NinoBleus/ES2_Amplifier/pcb/audio-amplifier/audio-amplifier.pdf

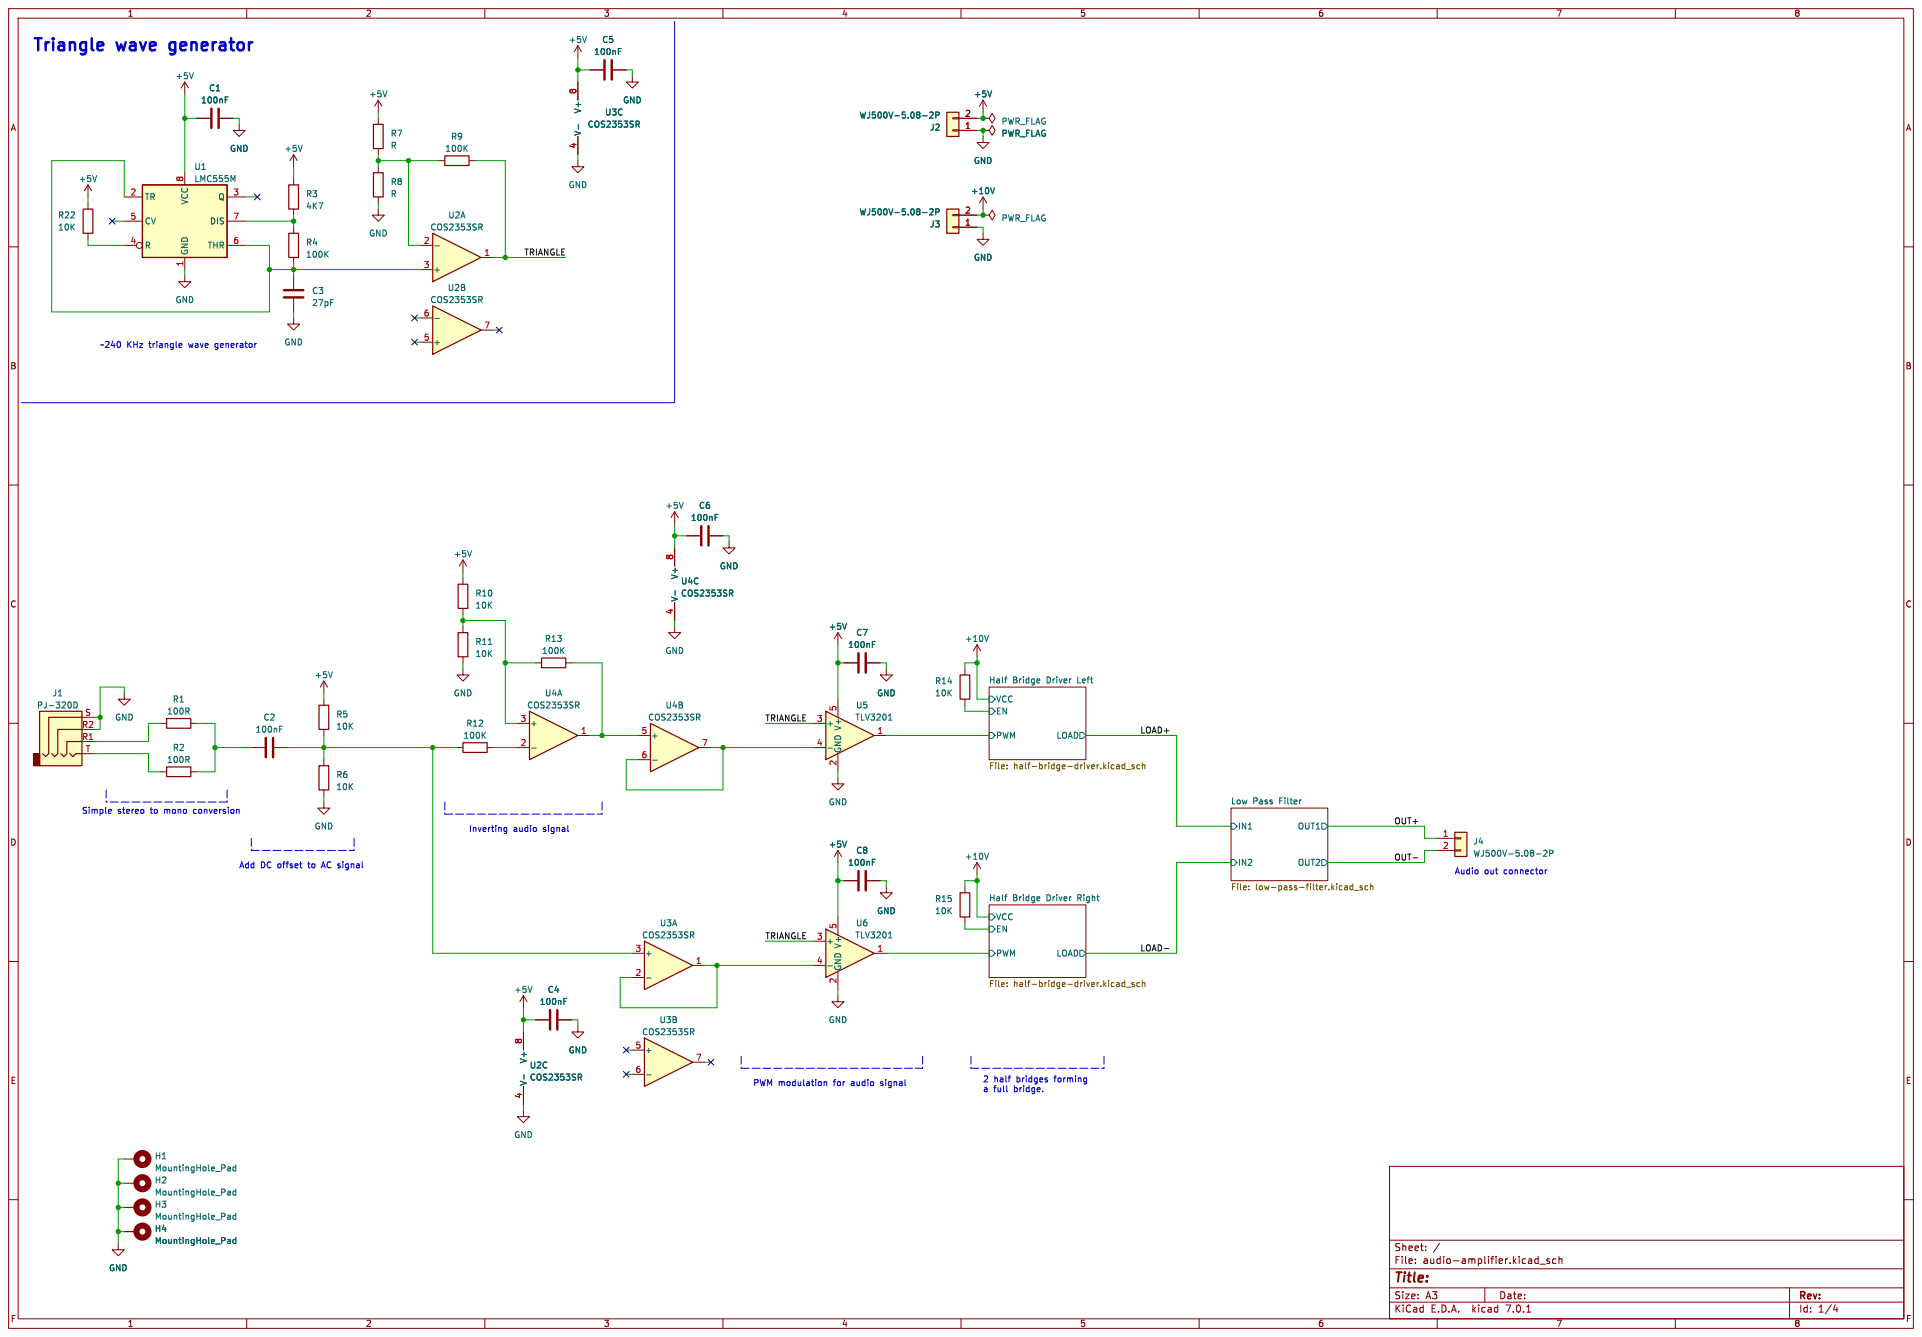
[picture p1: page 1]

Half Bridge Driver Left File: half-bridge-driver.kicad_sch

Low Pass Filter File: low-pass-filter.kicad_sch

Half Bridge Driver Right File: half-bridge-driver.kicad_sch

Id: 1/4 Title: File: audio-amplifier.kicad_sch Sheet: /

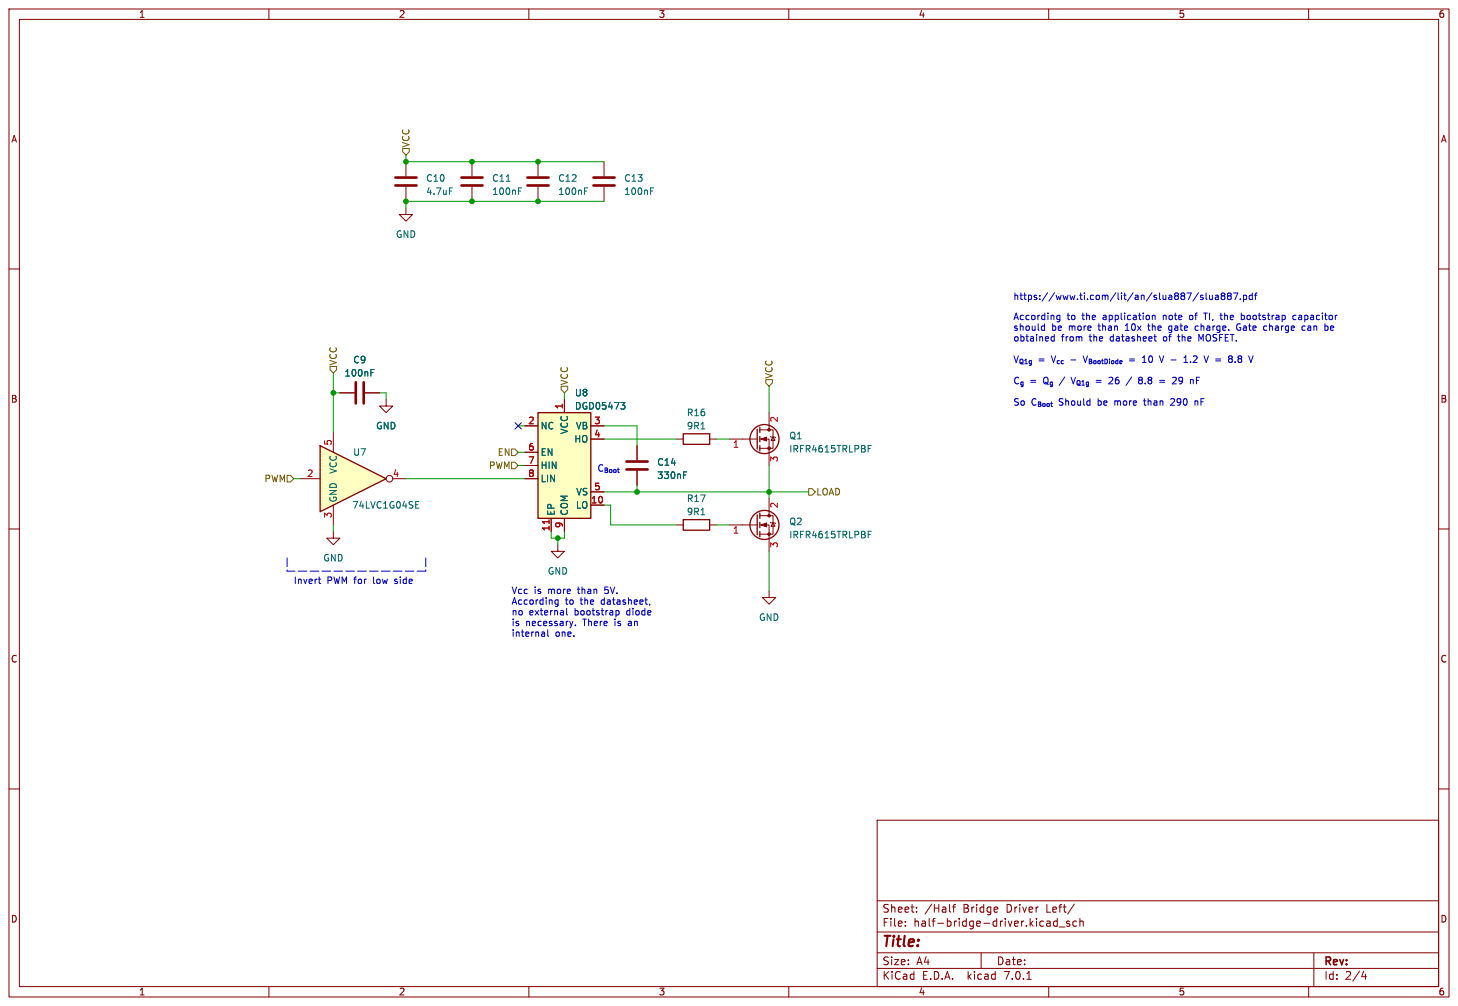
[picture p2: page 2]

https://www.ti.com/lit/an/slua887/slua887.pdf

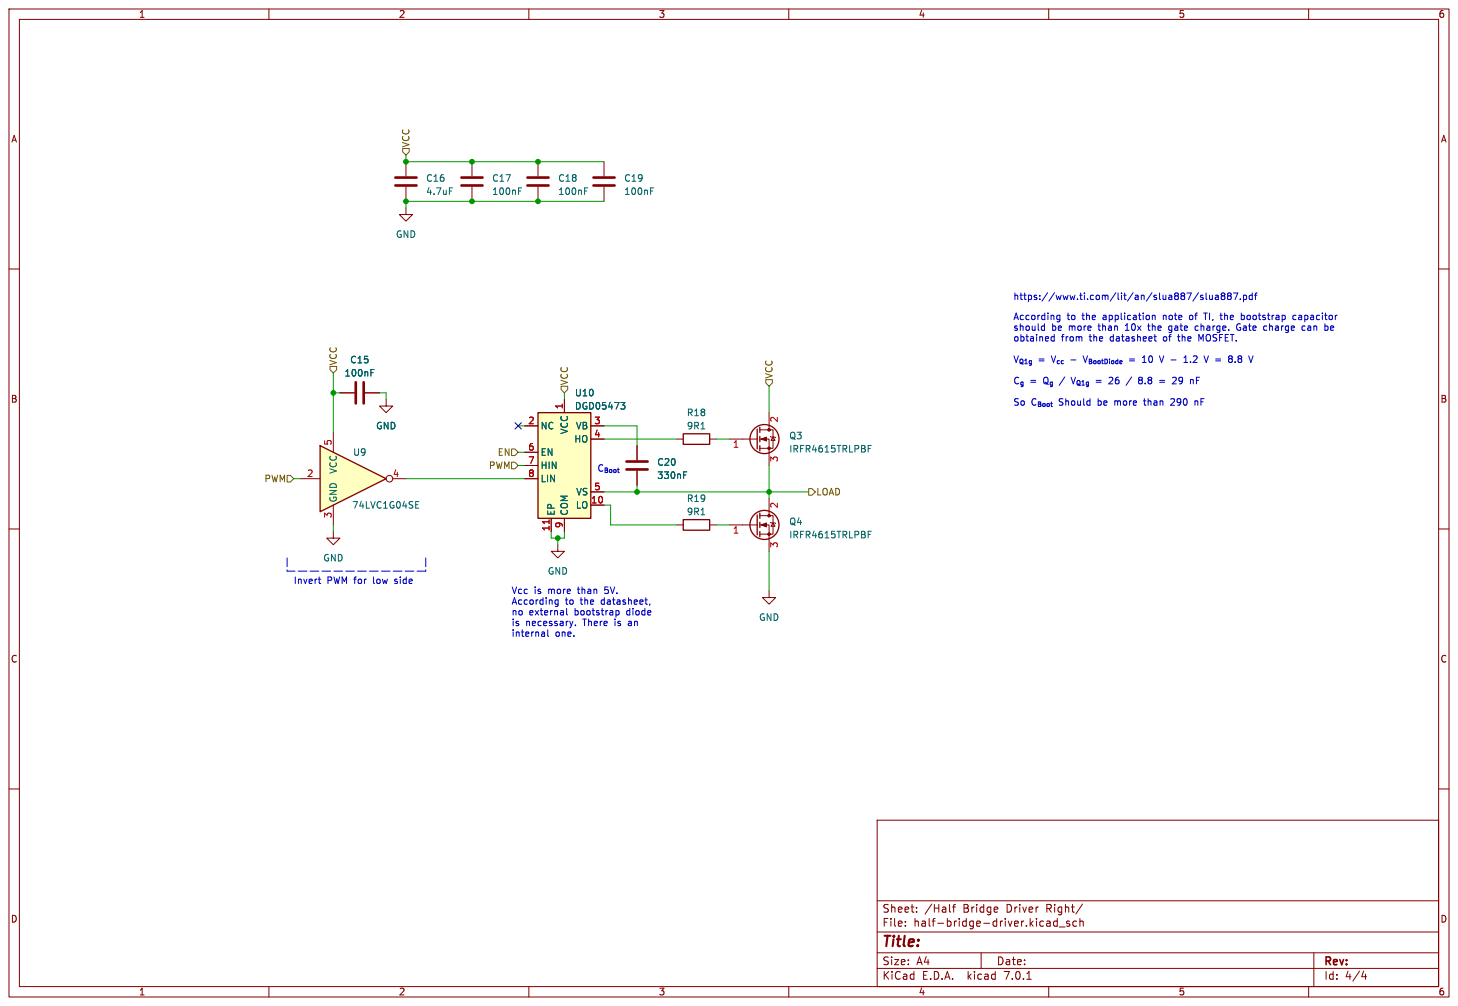
[picture p3: page 3]

https://www.ti.com/lit/an/slua887/slua887.pdf

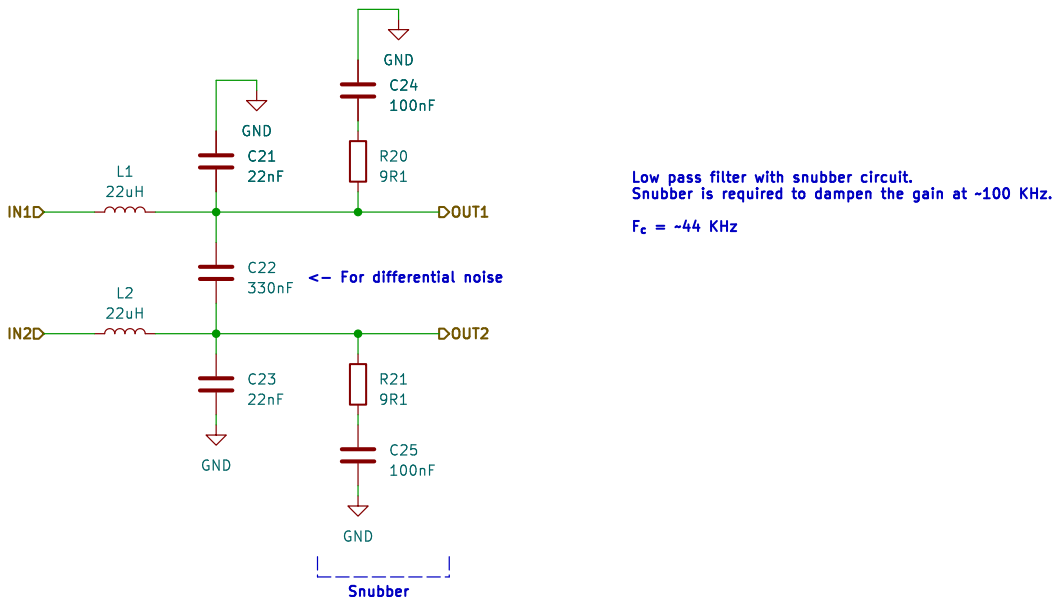
[picture p4: page 4]
