NinoBleus/ES2_Amplifier/sims/test.asc

C1: cap; 100n
C4: cap; 27p; V=50 Irms=0 Rser=0 Lser=0 mfg="Murata" pn="GRM0335C1H270JA01" type="C0G"
C5: cap; 0.1µ
R1: res; 10k; tol=1
R2: res; 10k; tol=1
R3: res; 100k; tol=1
R4: res; 10k; tol=1
R5: res; 10k; tol=1
R6: res; 100k; tol=1
R7: res; 100; tol=1
R8: res; 100k; tol=0.1 pwr=100m
R9: res; 4.7k; tol=0.1 pwr=100m
R10: res; 100; tol=1
R11: res; 100k; tol=1
R12: res; 226k; tol=1
R13: res; 226k; tol=1
R14: res; 50
R15: res; 50
R16: res; 10Meg
R17: res; 10Meg
U1: UniversalOpAmp2; Avol=1Meg GBW=50Meg Slew=38Meg
U2: UniversalOpAmp2; Avol=1Meg GBW=50Meg Slew=38Meg
U3: UniversalOpAmp2; Avol=1Meg GBW=50Meg Slew=38Meg
U4: opamp2; TLV3201
U6: NE555
U7: UniversalOpAmp2; Avol=1Meg GBW=50Meg Slew=38Meg
U8: opamp2; TLV3201
V1: voltage; SINE(0 1.45 3.45k 0 0 0)
V2: voltage; 5
V3: voltage; 10
V4: voltage; SINE(0 1.45 1k 0 0 120)
Named nets: 0, 5v, triangle, 10v
Input signal
.tran 0 5m 2m .1u
.model sw sw (Ron=.1 Roff=1Meg Vt=5)
*.tran 0 100u 50u 0.01u
.inc lib/TLV3201.lib
