NinoBleus/ES2_Amplifier/sims/real_components.asc

A1: buf; vt=5 vhigh=10 vlow=0
A2: buf; vt=5 vhigh=10 vlow=0
C1: cap; 100n
C2: cap; 1000n
C3: cap; 1000n
C4: cap; 27p; V=50 Irms=0 Rser=0 Lser=0 mfg="Murata" pn="GRM0335C1H270JA01" type="C0G"
C5: cap; 0.1µ
L1: ind; 10µ
L2: ind; 10µ
R1: res; 10k
R2: res; 10k
R3: res; 100k
R4: res; 10k
R5: res; 10k
R6: res; 100k
R7: res; 100
R8: res; 100k; tol=0.1 pwr=100m
R9: res; 4.7k; tol=0.1 pwr=100m
S1: sw
S2: sw
S3: sw
S4: sw
U1: UniversalOpAmp
U2: UniversalOpAmp
U3: UniversalOpAmp
U4: LT1721
U5: LT1721
U6: NE555
V1: voltage; SINE(0 1.5 1k 0 0 0)
V2: voltage; 10
Named nets: 0, sup, triangle
Input signal
.tran 0 5m 2m .1u
.model sw sw (Ron=.1 Roff=1Meg Vt=5)
*.tran 0 100u 50u 0.01u
