NinoBleus/ES2_Amplifier/sims/low_pass_filter.asc

B1: bv; V=v(n+)-v(n-)
C1: cap; 22n
C2: cap; 330n
C3: cap; 22n
C4: cap; 100n
C5: cap; 100n
C6: cap; 22n
C7: cap; 330n
C8: cap; 22n
C9: cap; 100n
C10: cap; 100n
CM: voltage; SINE(0 5 1k 0 0 0); AC 1
DM: voltage; SINE(0 5 1k 0 0 0); AC 1
L1: ind; 22µ
L2: ind; 22µ
L3: ind; 22µ
L4: ind; 22µ
R1: res; 100Meg
R2: res; 9.1
R3: res; 9.1
R4: res; 8
R6: res; 9.1
R7: res; 9.1
R8: res; 8
Named nets: 0, N+, N-, DM_response, CM1, CM2
.ac dec 100 100 10Meg
*.tran 0 2m 1m 0.1u
