NinoBleus/ES2_Amplifier/sims/stereo_to_mono.asc

C1: cap; 100n
R1: res; 100
R2: res; 100
R3: res; 10k
R4: res; 10k
U1: UniversalOpAmp1
V1: voltage; SINE(0 1.45 5k 0 0 0)
V2: voltage; SINE(0 1.45 3.45k 0 0 0)
V3: voltage; 5
Named nets: 0, 5v
.tran 0 3m 2m 0.1u
