NinoBleus/ES2_Amplifier/sims/theoretical.asc

A1: buf; vt=5 vhigh=10 vlow=0
A2: buf; vt=5 vhigh=10 vlow=0
C1: cap; 100n
C2: cap; 1000n
C3: cap; 1000n
L1: ind; 10µ
L2: ind; 10µ
R1: res; 10k
R2: res; 10k
R3: res; 100k
R4: res; 10k
R5: res; 10k
R6: res; 100k
R7: res; 100
S1: sw
S2: sw
S3: sw
S4: sw
U1: UniversalOpAmp
U2: UniversalOpAmp
U3: UniversalOpAmp
U4: LT1721
U5: LT1721
V1: voltage; SINE(0 4 1k 0 0 0)
V2: voltage; 10
V3: voltage; PULSE(0 10 0 5u 5u 1n 10u)
Named nets: 0, sup
Input signal
.tran 0 5m 2m .1u
Local triangle oscillator
.model sw sw (Ron=.1 Roff=1Meg Vt=5)
