NinoBleus/ES2_Amplifier/sims/triangle_oscillator.asc

C1: cap; 27p; V=50 Irms=0 Rser=0 Lser=0 mfg="Murata" pn="GRM0335C1H270JA01" type="C0G"
C2: cap; 0.1µ
R1: res; 100k; tol=0.1 pwr=100m
R2: res; 4.7k; tol=0.1 pwr=100m
U1: NE555
V1: voltage; 10
Named nets: 0, vcc
.tran 0 100u 50u 0.01u
