NinoBleus/ES2_Amplifier/pcb/audio-amplifier/audio-amplifier.kicad_pcb

## KiCad design pcb/audio-amplifier/audio-amplifier.kicad_pcb (2023-04-18)

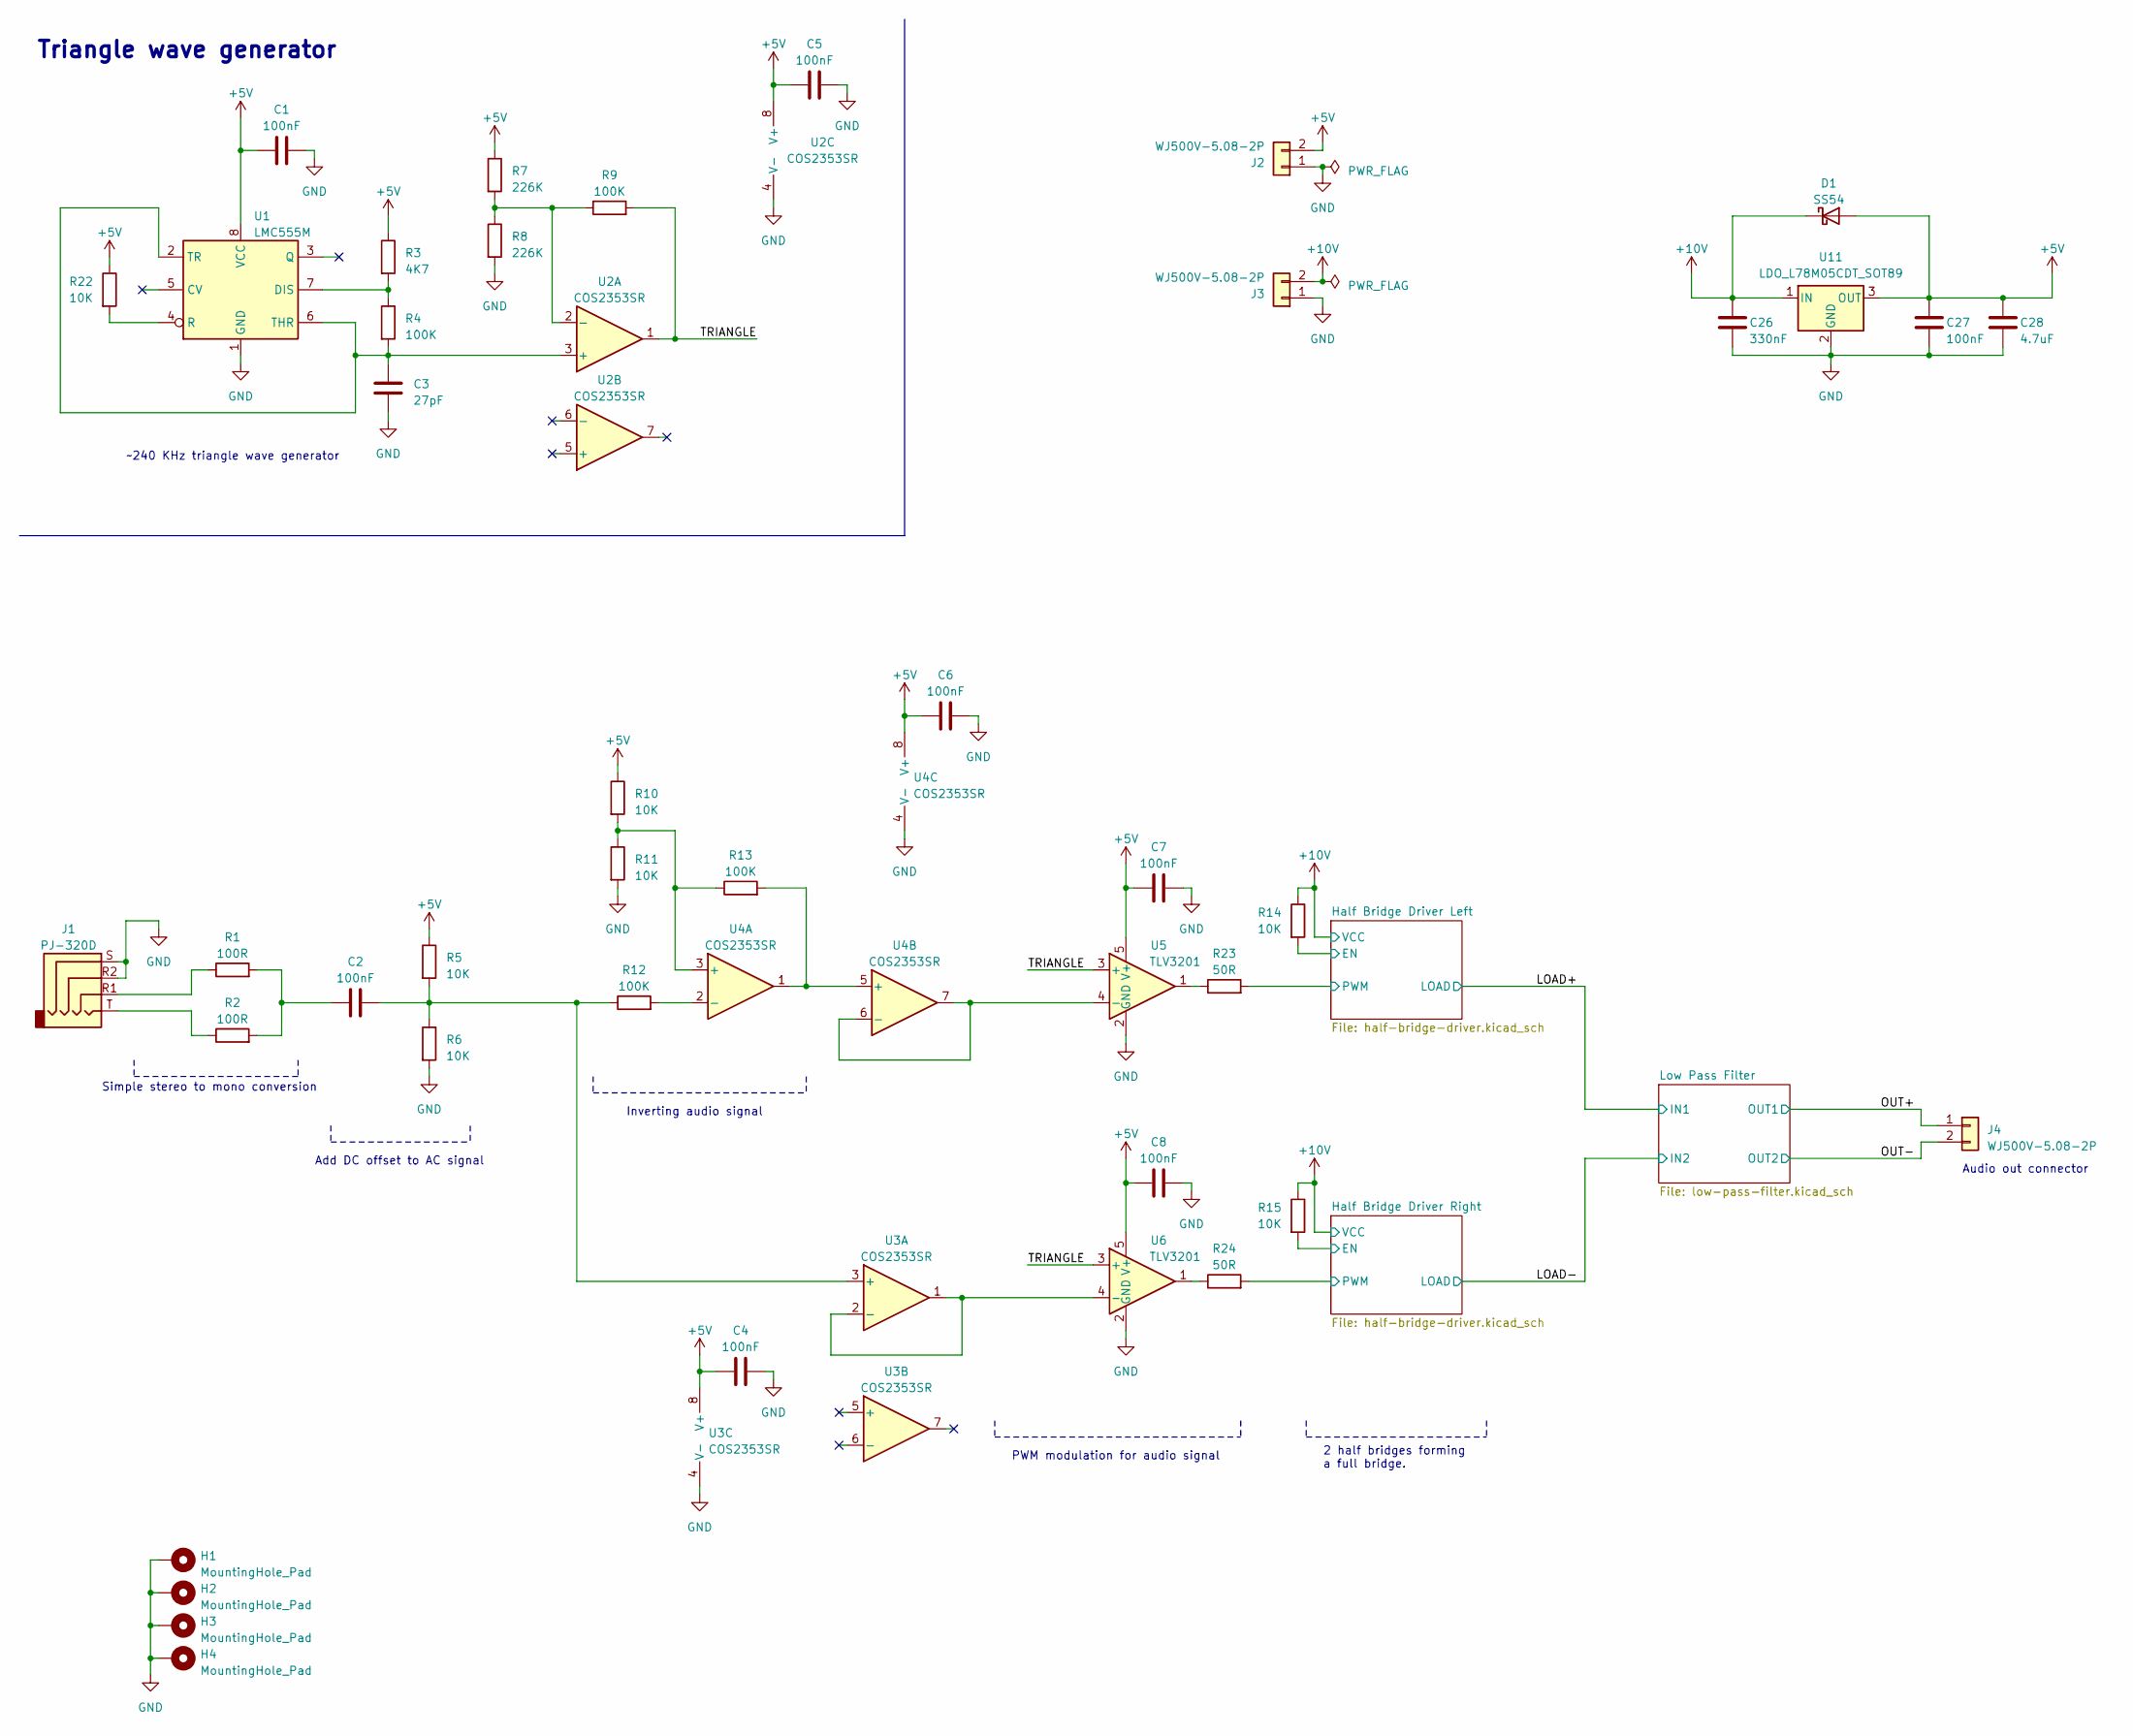
[picture p5: schematic audio-amplifier.kicad_sch]

Parts:
C1, C2, C4, C5, C6, C7, C8, C27: 100nF; C_0805_2012Metric; MPN CC0805KRX7R9BB104; LCSC Part # C49678
C3: 27pF; C_0603_1608Metric; MPN GRM1885C1H270FA01D; LCSC Part # C162215
C26: 330nF; C_0805_2012Metric; MPN 0805B334K500NT; LCSC Part # C1740
C28: 4.7uF; C_1206_3216Metric; MPN 1206B475K500NT; LCSC Part # C29823
D1: SS54; D_SMA_Handsoldering; MPN SS54; LCSC Part # C22452
H1, H2, H3, H4: MountingHole_Pad; MountingHole_3.2mm_M3_Pad_Via
J1: PJ-320D; Jack_3.5mm_PJ320D_Horizontal; LCSC Part # C431535
J2, J3, J4: WJ500V-5.08-2P; TerminalBlock_bornier-2_P5.08mm; MPN WJ500V-5.08-2P; LCSC Part # C8465
R1, R2: 100R; R_0805_2012Metric; LCSC Part # C17408
R3: 4K7; R_0603_1608Metric; MPN ARG03BTC4701; LCSC Part # C309085
R4: 100K; R_0603_1608Metric; MPN ARG03BTC1003; LCSC Part # C335088
R5, R6, R10, R11, R14, R15, R22: 10K; R_0805_2012Metric; MPN 0805W8F1002T5E; LCSC Part # C17414
R7, R8: 226K; R_0805_2012Metric; MPN RT0805BRD07226KL; LCSC Part # C865308
R9, R12, R13: 100K; R_0805_2012Metric; MPN 0805W8F1003T5E; LCSC Part # C149504
R23, R24: 50R; R_0805_2012Metric; MPN ARG05FTC0500; LCSC Part # C2828866
U1: LMC555M; SOP-8_3.9x4.9mm_P1.27mm; LCSC Part # C356725
U2, U3, U4: COS2353SR; SOP-8_3.9x4.9mm_P1.27mm; LCSC Part # C2685365
U5, U6: TLV3201; SOT-23-5; LCSC Part # C105188
U11: LDO_L78M05CDT_SOT89; TO-252-2; MPN L78M05CDT; LCSC Part # C55509

Connections:
+5V: C1.1, C4.1, C5.1, C6.1, C7.1, C8.1, C27.1, C28.1, D1.2 (A), J2.2, R3.1, R5.1, R7.1, R10.1, R22.1, U1.8 (VCC), U2.8 (V+), U3.8 (V+), U4.8 (V+), U5.5 (V+), U6.5 (V+), U11.3 (OUT); also elsewhere on the board
+10V: C26.1, D1.1 (K), J3.2, R14.1, R15.1, U11.1 (IN); also elsewhere on the board
/Half Bridge Driver Left/EN: R14.2; also elsewhere on the board
/Half Bridge Driver Left/PWM: R23.2; also elsewhere on the board
/Half Bridge Driver Right/EN: R15.2; also elsewhere on the board
/Half Bridge Driver Right/PWM: R24.2; also elsewhere on the board
/OUT+: J4.1; also elsewhere on the board
/OUT-: J4.2; also elsewhere on the board
/TRIANGLE: R9.2, U2.1, U5.3 (+), U6.3 (+)
GND: C1.2, C3.2, C4.2, C5.2, C6.2, C7.2, C8.2, C26.2, C27.2, C28.2, H1.1, H2.1, H3.1, H4.1, J1.R2, J1.S, J2.1, J3.1, R6.2, R8.2, R11.2, U1.1 (GND), U2.4 (V-), U3.4 (V-), U4.4 (V-), U5.2 (GND), U6.2 (GND), U11.2 (GND); also elsewhere on the board
unnamed: C2.1, R1.2, R2.2
unnamed: J1.R1, R1.1
unnamed: J1.T, R2.1
unnamed: R23.1, U5.1
unnamed: R24.1, U6.1
unnamed: R3.2, R4.1, U1.7 (DIS)
unnamed: R22.2, U1.4 (R)
unnamed: C3.1, R4.2, U1.2 (TR), U1.6 (THR), U2.3 (+)
unnamed: R7.2, R8.1, R9.1, U2.2 (-)
unnamed: C2.2, R5.2, R6.1, R12.1, U3.3 (+)
unnamed: U3.1, U3.2 (-), U6.4 (-)
unnamed: R10.2, R11.1, R13.1, U4.3 (+)
unnamed: R12.2, U4.2 (-)
unnamed: R13.2, U4.1, U4.5 (+)
unnamed: U4.6 (-), U4.7, U5.4 (-)

Notes on the sheet:
Audio out connector
Simple stereo to mono conversion
PWM modulation for audio signal
~240 KHz triangle wave generator
Inverting audio signal
Add DC offset to AC signal
2 half bridges forming a full bridge.
Triangle wave generator

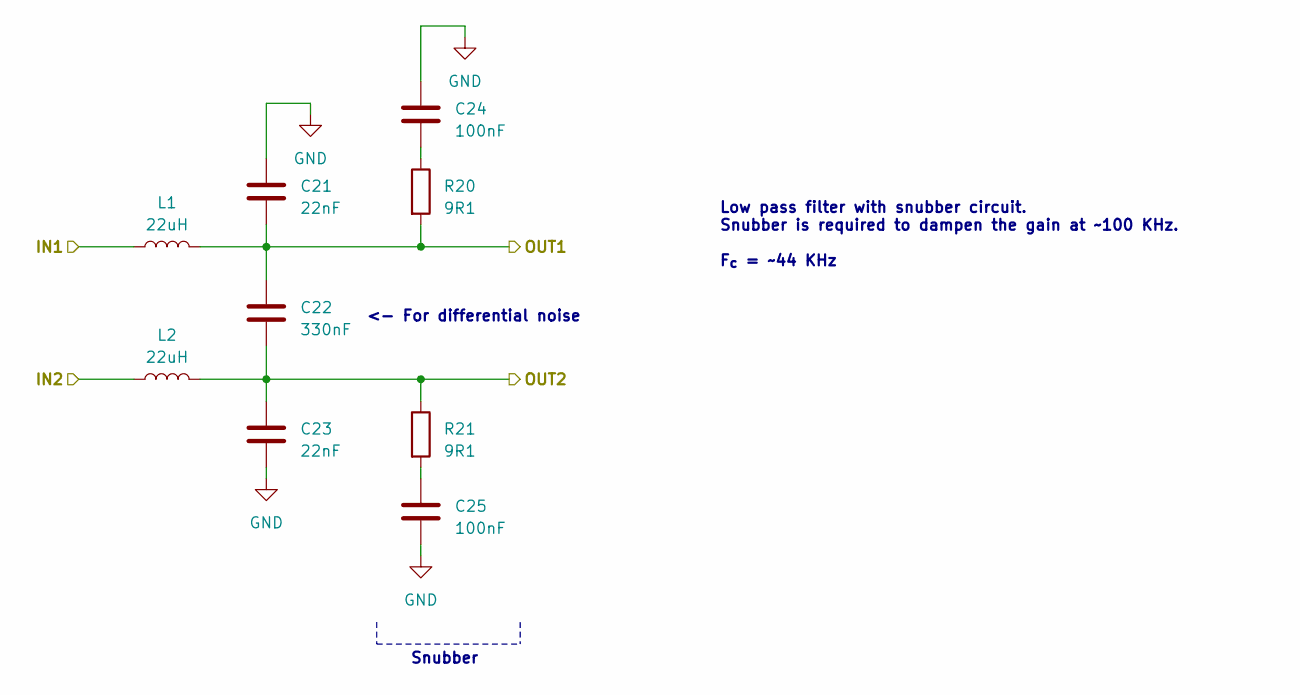
[picture p6: schematic low-pass-filter.kicad_sch]

Parts:
C21, C23: 22nF; C_0805_2012Metric; MPN CL21B223KBANNNC; LCSC Part # C1729
C22: 330nF; C_0805_2012Metric; MPN 0805B334K500NT; LCSC Part # C1740
C24, C25: 100nF; C_0805_2012Metric; MPN CC0805KRX7R9BB104; LCSC Part # C49678
L1, L2: 22uH; L_Sunlord_SWPA6045S; MPN SWPA6045S220MT; LCSC Part # C83454
R20, R21: 9R1; R_0805_2012Metric; MPN FRC0805F9R10TS; LCSC Part # C2933515

Connections:
/LOAD+: L1.1; also elsewhere on the board
/LOAD-: L2.1; also elsewhere on the board
/OUT+: C21.2, C22.1, L1.2, R20.2; also elsewhere on the board
/OUT-: C22.2, C23.1, L2.2, R21.1; also elsewhere on the board
GND: C21.1, C23.2, C24.1, C25.2; also elsewhere on the board
unnamed: C24.2, R20.1
unnamed: C25.1, R21.2

Notes on the sheet:
<- For differential noise
Low pass filter with snubber circuit. Snubber is required to dampen the gain at ~100 KHz. F_{c} = ~44 KHz
Snubber

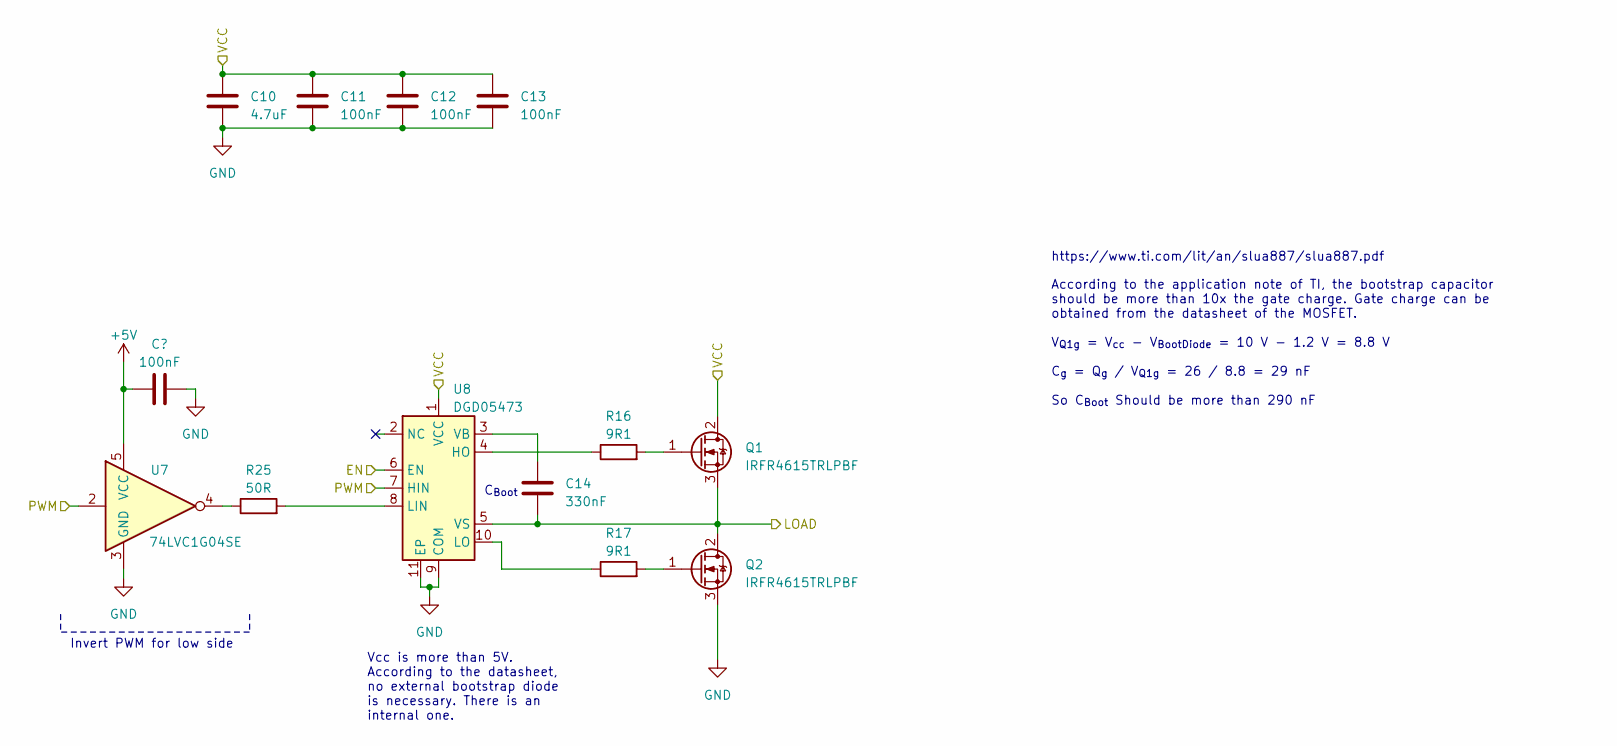
[picture p7: schematic half-bridge-driver.kicad_sch]

Parts:
C9, C11, C12, C13: 100nF; C_0805_2012Metric; MPN CC0805KRX7R9BB104; LCSC Part # C49678
C10: 4.7uF; C_1206_3216Metric; MPN 1206B475K500NT; LCSC Part # C29823
C14: 330nF; C_0805_2012Metric; MPN 0805B334K500NT; LCSC Part # C1740
Q1, Q2: IRFR4615TRLPBF; TO-252-2; MPN IRFR4615TRLPBF; LCSC Part # C148159
R16, R17: 9R1; R_0805_2012Metric; MPN FRC0805F9R10TS; LCSC Part # C2933515
R25: 50R; R_0805_2012Metric; MPN ARG05FTC0500; LCSC Part # C2828866
U7: 74LVC1G04SE; SOT-353_SC-70-5; MPN 74LVC1G04SE; LCSC Part # C264081
U8: DGD05473; DFN-10-1EP_3x3mm_P0.5mm_EP1.65x2.38mm; LCSC Part # C189752

Connections:
+5V: C9.1, U7.5 (VCC); also elsewhere on the board
+10V: C10.1, C11.1, C12.1, C13.1, Q1.2 (D), U8.1 (VCC); also elsewhere on the board
/Half Bridge Driver Left/EN: U8.6 (EN); also elsewhere on the board
/Half Bridge Driver Left/PWM: U7.2, U8.7 (HIN); also elsewhere on the board
/LOAD+: C14.2, Q1.3 (S), Q2.2 (D), U8.5 (VS); also elsewhere on the board
GND: C9.2, C10.2, C11.2, C12.2, C13.2, Q2.3 (S), U7.3 (GND), U8.9 (COM), U8.11 (EP); also elsewhere on the board
unnamed: Q1.1 (G), R16.2
unnamed: Q2.1 (G), R17.2
unnamed: R25.1, U7.4
unnamed: R16.1, U8.4 (HO)
unnamed: R25.2, U8.8 (LIN)
unnamed: R17.1, U8.10 (LO)
unnamed: C14.1, U8.3 (VB)

Parts of its further copies:
C15, C17, C18, C19: 100nF; C_0805_2012Metric; MPN CC0805KRX7R9BB104; LCSC Part # C49678
C16: 4.7uF; C_1206_3216Metric; MPN 1206B475K500NT; LCSC Part # C29823
C20: 330nF; C_0805_2012Metric; MPN 0805B334K500NT; LCSC Part # C1740
Q3, Q4: IRFR4615TRLPBF; TO-252-2; MPN IRFR4615TRLPBF; LCSC Part # C148159
R18, R19: 9R1; R_0805_2012Metric; MPN FRC0805F9R10TS; LCSC Part # C2933515
R26: 50R; R_0805_2012Metric; MPN ARG05FTC0500; LCSC Part # C2828866
U9: 74LVC1G04SE; SOT-353_SC-70-5; MPN 74LVC1G04SE; LCSC Part # C264081
U10: DGD05473; DFN-10-1EP_3x3mm_P0.5mm_EP1.65x2.38mm; LCSC Part # C189752

Connections of its further copies:
+5V: C15.1, U9.5 (VCC); also elsewhere on the board
+10V: C16.1, C17.1, C18.1, C19.1, Q3.2 (D), U10.1 (VCC); also elsewhere on the board
/Half Bridge Driver Right/EN: U10.6 (EN); also elsewhere on the board
/Half Bridge Driver Right/PWM: U9.2, U10.7 (HIN); also elsewhere on the board
/LOAD-: C20.2, Q3.3 (S), Q4.2 (D), U10.5 (VS); also elsewhere on the board
GND: C15.2, C16.2, C17.2, C18.2, C19.2, Q4.3 (S), U9.3 (GND), U10.9 (COM), U10.11 (EP); also elsewhere on the board
unnamed: Q3.1 (G), R18.2
unnamed: Q4.1 (G), R19.2
unnamed: R26.1, U9.4
unnamed: R18.1, U10.4 (HO)
unnamed: R26.2, U10.8 (LIN)
unnamed: R19.1, U10.10 (LO)
unnamed: C20.1, U10.3 (VB)

Notes on the sheet:
C_{Boot}
Vcc is more than 5V. According to the datasheet, no external bootstrap diode is necessary. There is an internal one.
https://www.ti.com/lit/an/slua887/slua887.pdf
Invert PWM for low side
According to the application note of TI, the bootstrap capacitor should be more than 10x the gate charge. Gate charge can be obtained from the datasheet of the MOSFET. V_{Q1g} = V_{cc} - V_{BootDiode} = 10 V - 1.2 V = 8.8 V C_{g} = Q_{g} / V_{Q1g} = 26 / 8.8 = 29 nF So C_{Boot} Should be more than 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

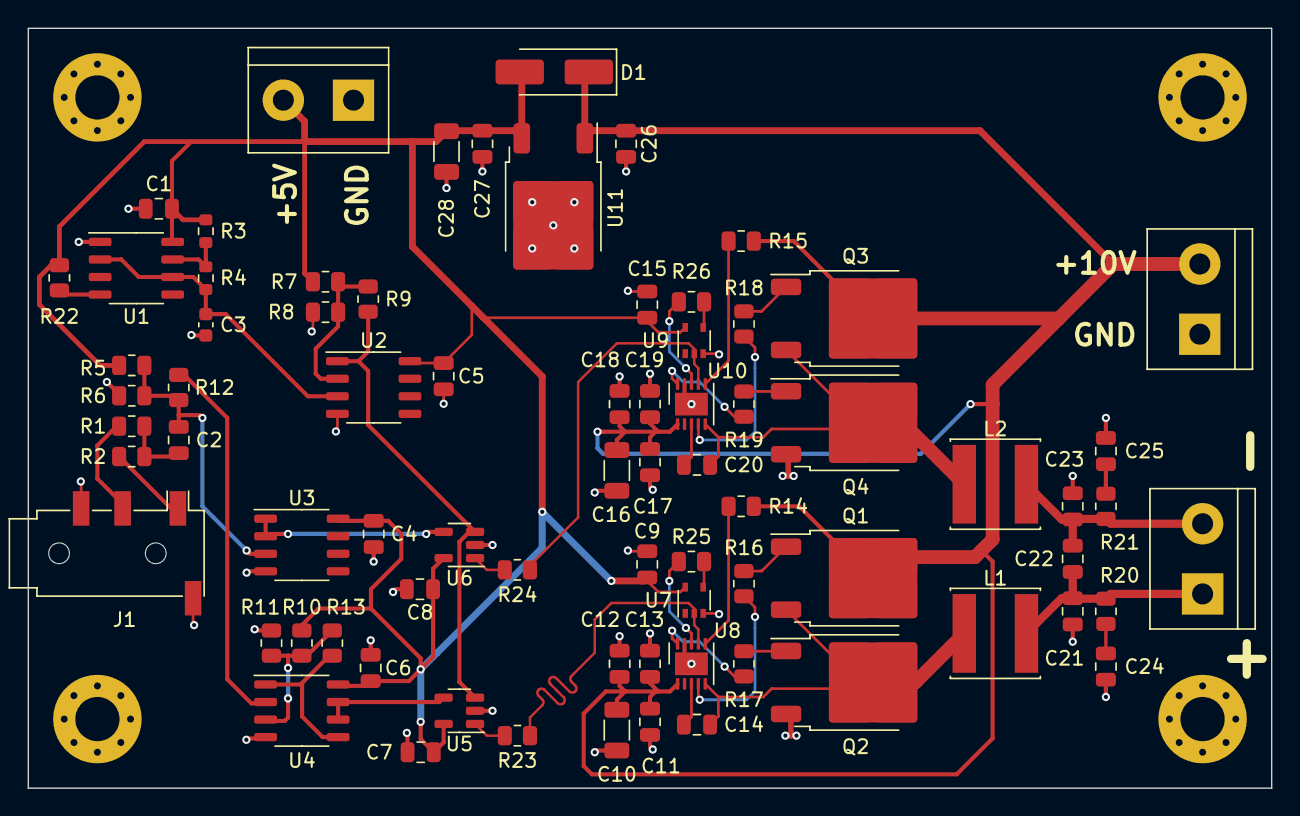
[picture p8: board audio-amplifier.kicad_pcb from above]

Board: 4 copper layers, 90.0 x 55.0 mm, 80 parts (0 on the bottom side), 43 nets.
