NinoBleus/ES2_Amplifier/(commit log)

2023-02-28 Aanmaken altium files
    [PCB_Project.PrjPcb]
2023-02-28 Add gitignore
    [Amplifier.PrjPcb, PCB_Project.PrjPcb]
2023-03-09 sims: Add current LTspice simulations
2023-03-22 pcb: Remove Altium project
    [Amplifier.PrjPcb]
2023-03-22 pcb: Init kicad project
    [audio-amplifier.kicad_pcb, audio-amplifier.kicad_sch]
2023-03-24 pcb: Add PCB
    [audio-amplifier.kicad_pcb, audio-amplifier.kicad_sch, half-bridge-driver.kicad_sch, low-pass-filter.kicad_sch]
2023-03-24 pcb: Comment out .csv in gitignore
    [bom.csv, designators.csv, positions.csv]
2023-04-18 Add old PCB
    [audio-amplifier_reva.kicad_pcb]
2023-04-18 Add updated PCB
    [audio-amplifier.kicad_pcb, audio-amplifier.kicad_sch, bom.csv, designators.csv, half-bridge-driver.kicad_sch, positions.csv]
2023-04-18 Fix via placement
    [audio-amplifier.kicad_pcb]
